asterane/analog-design/amplifier/amp_2.jpg

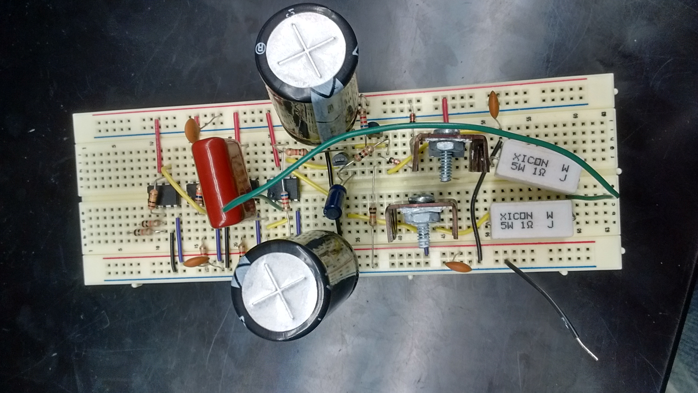
amplifier/amp_2.jpg
