asterane/analog-design/amplifier/amp_3.jpg

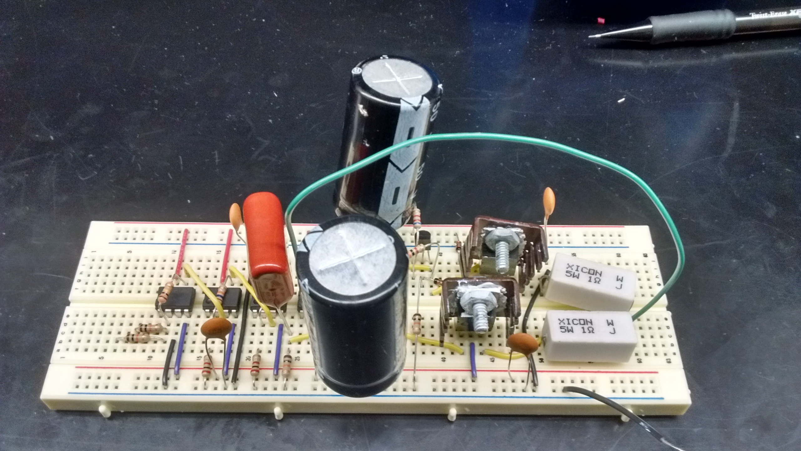
amplifier/amp_3.jpg
