asterane/analog-design/amplifier/amp_schematic.png

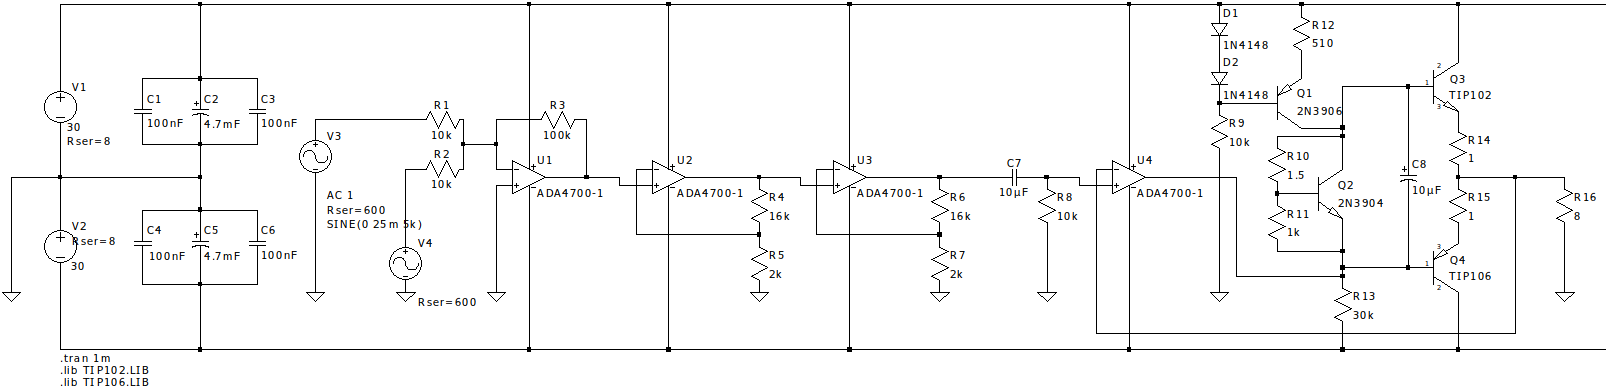
amplifier/amp_schematic.png
