asterane/analog-design/oscillator/WeinBridge.png

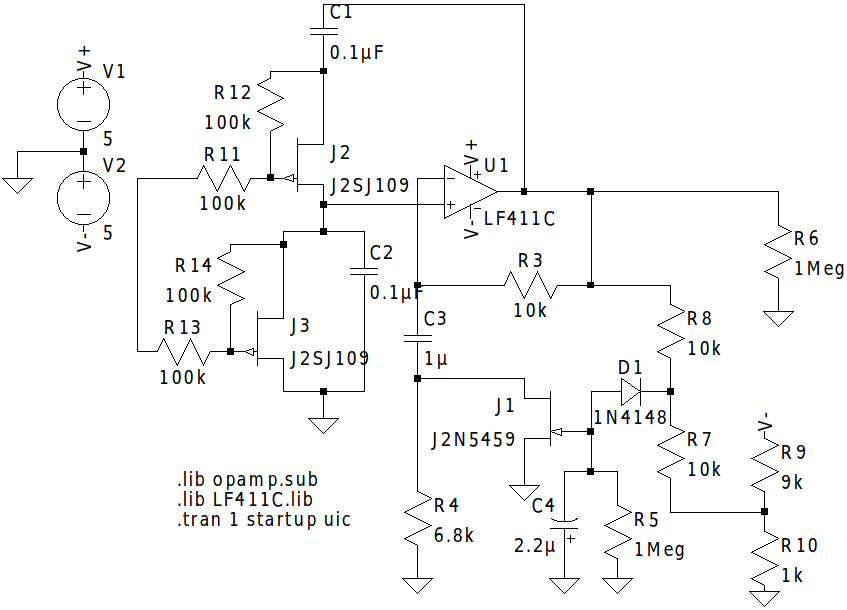
oscillator/WeinBridge.png
