asterane/analog-design/amplifier/amp-v1/AmpSchematic.pdf

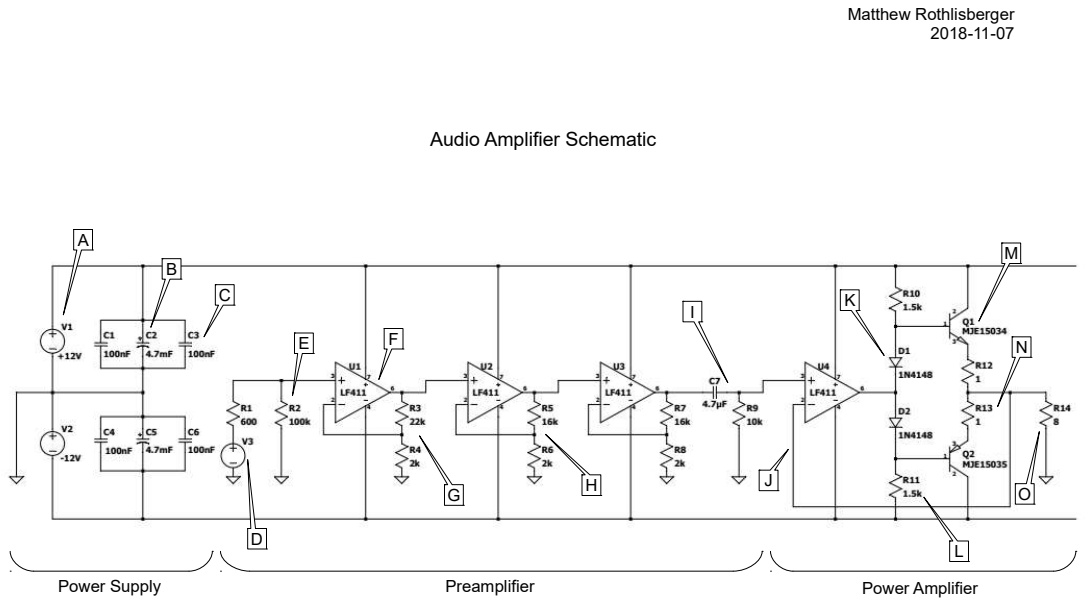
[picture p6: page 1]
Matthew Rothlisberger 2018-11-07; Power Supply; Preamplifier; Power Amplifier

Audio Amplifier Schematic
