asterane/analog-design/amplifier/amp-v1/Amplifier.pdf

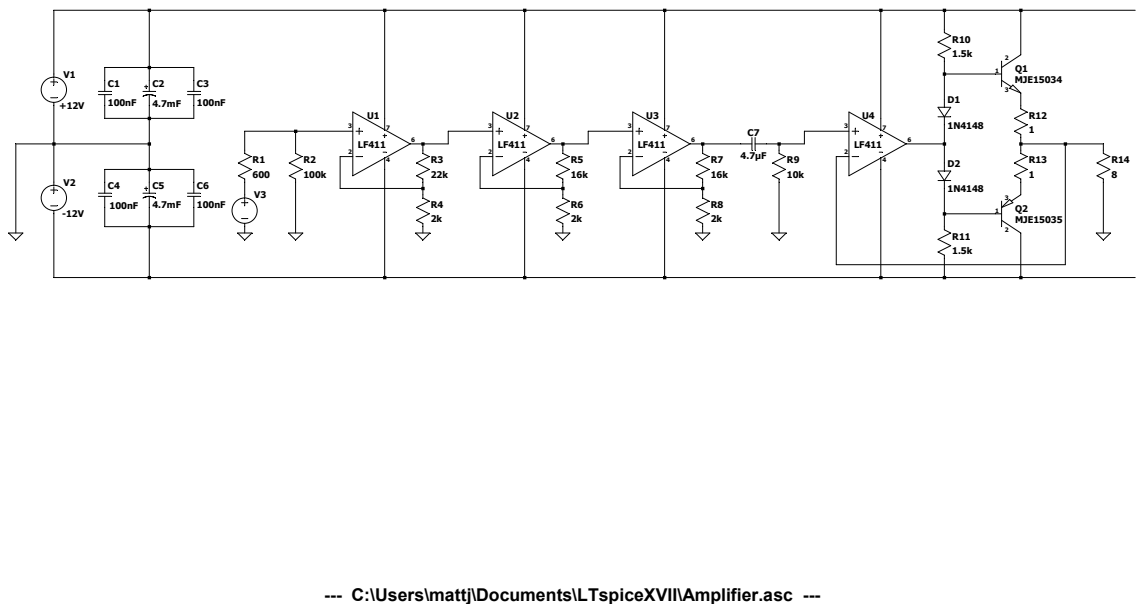
[picture p7: page 1]

--- C:\Users\mattj\Documents\LTspiceXVII\Amplifier.asc ---
