asterane/analog-design/amplifier/sim/30Vamp.asc

C1: cap; 100nF
C2: polcap; 4.7mF
C3: cap; 100nF
C4: cap; 100nF
C5: polcap; 4.7mF
C6: cap; 100nF
C7: cap; 10µF
C8: polcap; 10µF
D1: diode; 1N4148
D2: diode; 1N4148
Q1: pnp; 2N3906
Q2: npn; 2N3904
Q3: npn; ""
Q4: pnp; ""
R1: res; 10k
R2: res; 10k
R3: res; 100k
R4: res; 16k
R5: res; 2k
R6: res; 16k
R7: res; 2k
R8: res; 10k
R9: res; 10k
R10: res; 1.5
R11: res; 1k
R12: res; 510
R13: res; 30k
R14: res; 1; pwr=5
R15: res; 1; pwr=5
R16: res; 8; pwr=5
U1: ADA4700-1
U2: ADA4700-1
U3: ADA4700-1
U4: ADA4700-1
V1: voltage; 30; Rser=8
V2: voltage; 30; Rser=8
V3: signal; SINE(0 25m 5k); AC 1; Rser=600
V4: signal; ""; Rser=600
Named nets: 0
1
2
3
1
3
2
.lib TIP102.LIB
.lib TIP106.LIB
.tran 1m
.lib MJE15034.LIB
.lib MJE15035.LIB
TIP102
TIP106
