asterane/analog-design/oscillator/sim/WeinBridge.asc

C1: cap; 0.1µF
C2: cap; 0.1µF
C3: cap; 1µ
C4: polcap; 2.2µ
D1: diode; 1N4148
J1: njf; J2N5459
J2: pjf; J2SJ109
J3: pjf; J2SJ109
R3: res; 10k
R4: res; 6.8k
R5: res; 1Meg
R6: res; 1Meg
R7: res; 10k
R8: res; 10k
R9: res; 9k
R10: res; 1k
R11: res; 100k
R12: res; 100k
R13: res; 100k
R14: res; 100k
U1: opamp2; LF411C
V1: voltage; 5
V2: voltage; 5
Named nets: 0, V+, V-
.lib LF411C.lib
.tran 1 startup uic
.lib opamp.sub
